ocraciun/carbon_monoxide_controller/docs/documentatie.pdf

# Circuit pentru controlul concentrației de monoxid de carbon într-o incintǎ

### Tehnici CAD

D I N C L U J - N A P O C A

UNIVERSITATEA
TEHNICA

### Crǎciun Octavian Ionuț

### 30 mai 2024

### Cuprins

1 Date de proiectare | 2
2 Fundamentare teoretică | 3
3 Proiectarea circuitului | 9
4 Breviar de calcul | 12
5 Rezultate si simulǎri | 15
Bibliografie | 22

### Capitolul 1

### Date de proiectare

Sǎ se proiecteze un sistem care utilizeazǎ senzori de gaz rezistivi pentru a menține într-o incintǎ concentrația de monoxid de carbon între limitele specificate in Tabela 1.1. În incintǎ existǎ o sursǎ care genereazǎ încontinuu monoxid de carbon. În momentul în care concentrația a ajuns la limita superioarǎ, sistemul va porni ventilatorul care va introduce aer curat. Când concentrația de monoxid de carbon ajunge la limita inferioarǎ sistemul va da comanda de oprire a ventilatorului.
Din foaia de catalog se știe cǎ la variația de gaz specificatǎ in Tabela 1.1 rezistența electricǎ a senzorului variazǎ liniar în domeniul specificat.
Variația rezistenței electrice a senzorului trebuie convertitǎ într-o variație de tensiune în domeniul [2V; (V CC − 2V)].
Ventilatorul este comandat de un comparator cu histerezǎ prin intermediul unui releu care este modelat cu un rezistor. Starea ventilatorului este semnalizatǎ de un LED de culoare verde.
concentrația de monoxid de carbon în incintǎ [ppm] | domeniul de mǎsurare a senzorului [ppm] | rezistența senzorului [Ω] | VCC [V]
200 – 4000 | 10 – 8000 | 55K – 45K | 11

Tabela 1.1: Date de proiectare

### Capitolul 2

### Fundamentare teoretică

Senzorii rezistivi sunt printre cei mai comuni tipuri de senzori, sunt ieftin de produs şi destul de uşor de conectat în circuit. Aceşti senzori produc o micǎ schimbare a rezistenței lor echivalente la modificǎri ale mediului exterior (în cazul nostru, a cantitǎții de monoxid de carbon), de aceea, pentru a mǎsura cât mai exact aceastǎ schimbare, este nevoie de o acuratețe cât mai bunǎ.
O tehnicǎ de mǎsurare a rezistenței senzorului (prezentatǎ in Figura 2.1) este de a forța un curent constant prin acesta, și sǎ se mǎsoare tensiunea care cade pe el. Dezavantajul acestei metode este cǎ necesitǎ o sursǎ de curent foarte exactǎ, deoarece orice modificare a valorii curentului generat de sursǎ v-a fi interpretatǎ la ieșire ca o modificare a rezistenței senzorului.

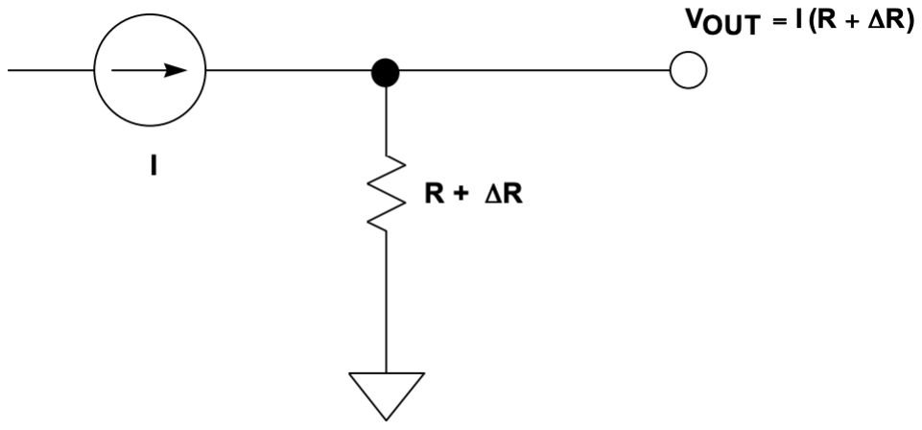
[picture p1: figure]

Figura 2.1: Mǎsurarea indirectǎ a rezistenței

### 2.1 Puntea Wheatstone în regim dezechilibrat

O alternativǎ pentru mǎsurarea schimbǎrilor mici ale rezistenței o prezintǎ circuitele in punte. Puntea Wheatstone în regim dezechilibrat prezentatǎ în Figura 2.2 este utilizatǎ la mǎsurarea pe cale electricǎ a unor mǎrimi neelectrice (in cazul nostru, pentru mǎsurarea cantitǎții de monoxid de carbon). Variațiile senzorului rezistiv ∆R sunt convertite într-o variație de tensiune ∆Vo.

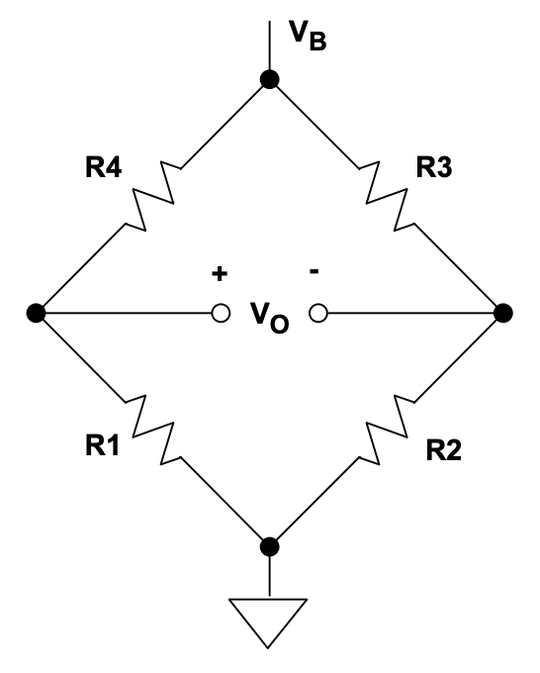
[picture p2: figure]

Figura 2.2: Puntea Wheatstone

### 2.1.1 Principiul de funcționare

În diagonala de alimentare a punții se conecteazǎ o sursǎ de tensiune continuǎ având rezistența echivalentǎ 0 Ω şi tensiunea Ua de 11 V. În diagonala de mǎsurare a punții se conecteazǎ un amplificator de instrumentație, având impedanța de intrare foarte mare in comparație cu rezistența de ieșire a punții, încât circuitul de mǎsurare funcționeazǎ în gol [2]. Astfel, este propriu sǎ caracterizǎm puntea prin sensibilitatea relativǎ în tensiune prezentatǎ prin Ecuația 2.1. Tensiunea în diagonala de mǎsurare a punții este prezentatǎ in Ecuația 2.2.

S =

∆Vo
VB
∆R
R

(2.1)

∆Vo = VB ·

R1
R1 + R2

− VB ·

R4
R3 + R4

(2.2)

Inițial, valorile acestor rezistențe sunt egale (R1 = R2 = R3 = R4 = R), întrucât puntea se aflǎ la echilibru deci ∆Vo = 0. Pentru o micǎ variație a rezistenței R4 = R + ∆R, celelalte valori ale rezistențelor rǎmân neschimbate, iar Ecuația 2.2 devine:

∆Vo = −

VB
4

∆R
R +

∆R
2

(2.3)

Ideal ar fi ca mǎrimea de ieșire ∆Vo sǎ varieze liniar in raport cu mǎrimea de intrare, ∆R, astfel se poate defini valoarea idealǎ și eroarea relativǎ de neliniaritate:

∆Videal =

VB
4

∆R
R

(2.4)

εrn =

∆V − ∆Videal

∆Videal

= −

∆R
2R

(2.5)

### 2.2 Amplificatorul de instrumentație

Pentru conversia variației tensiunii ∆Vo de la ieșirea punții wheatstone la domeniul cerut in datele de proiectare, se va utiliza un amplificator de instrumentație ca in Figura 2.3. Aceste tipuri de amplificator oferǎ o bunǎ stabilitate a amplificǎrii (setatǎ cu ajutorul unei singure rezistențe, RG), nu dezechilibreazǎ puntea şi oferǎ o bunǎ rejecție a semnalelor de mod comun (CMR).

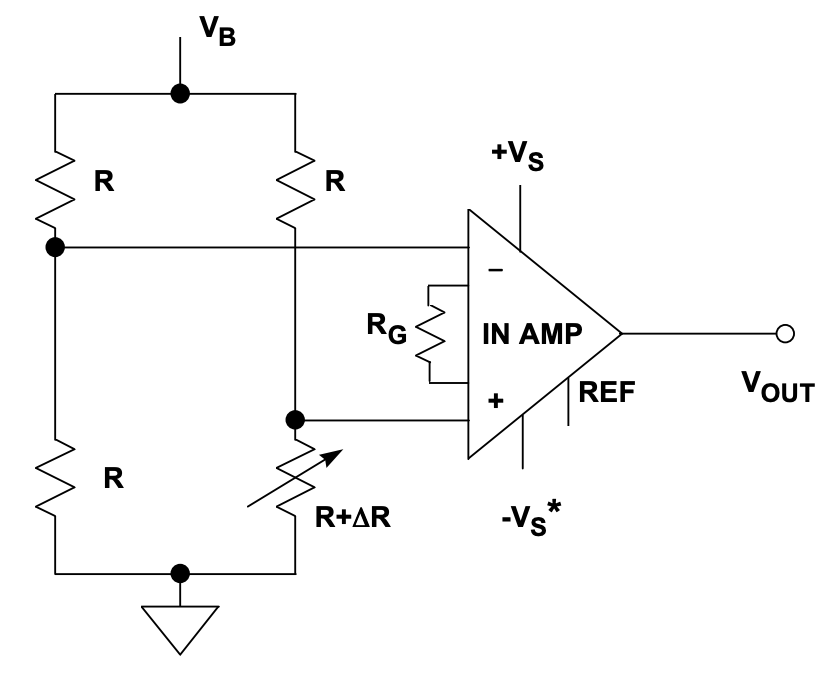
[picture p3: figure]

Figura 2.3: Utilizarea unui INA cu puntea wheatstone conform[5]

### 2.2.1 Principiul de funcționare

Variația tensiunii de pe ieșirea punții se va transforma într-o variație de tensiune la ieșirea INA confrom Ecuației 2.6. Se poate observa cǎ tensiunea de mod comun de pe cele douǎ intrari ale amplificatorului de instrumentație nu este prezentǎ la ieșirea acestuia, ci doar tensiunea diferențialǎ.

VOUT = (V

+ − V

−) ∗ Gain + VREF | (2.6)

### 2.2.2 Filtrarea zgomotului şi a interferenței electromagnetice

Undele radio de înaltǎ frecvențǎ (RFI) şi zgomotul surselor de tensiune afecteazǎ în mod negativ performanțele circuitelor analogice de precizie. Chiar dacǎ frecvențele acestor surse de zgomot nu intrǎ în lǎțimea de bandǎ a amplificatorului de instrumentație, acest zgomot poate ajunge în interiorul amplificatorului prin pinii de intrare, ieșire sau alimentare, unde este redresat și v-a produce un decalaj a semnalului de ieșire. Din aceste motive, este necesarǎ o bunǎ filtrare a intrǎrilor amplificatorului şi a alimentǎrii acestuia. În Figura 2.4 este prezentatǎ o schemǎ de principiu a unui filtru adecvat pentru intrǎrile amplificatorului de instrumentație. Aceastǎ schemǎ conține filtrul de mod comun (R1 : C1, R2 : C2) și filtrul diferențial (R1 + R2 : C3). Valorile R1, R2, C1, C2 se calculeazǎ conform Ecuației 2.7, și este important sǎ se asigure o bunǎ potrivire a acestor valori (R1 = R2, C1 = C2), de aceea este necesarǎ utilizarea componentelor cu o toleranțǎ cât mai micǎ. Valoarea condensatorului C3 se calculeazǎ conform Ecuației 2.8, și ajutǎ la atenuarea semnalului diferențial care rezultǎ din potrivirea inexactǎ a componentelor filtrului de mod comun. Lǎțimea de bandǎ a filtrului diferențial se calculeazǎ cu Ecuația 2.9, și trebuie sǎ fie de 100 de ori mai mare decât a semnalului de la intrare pentru a ne asigura cǎ acesta nu este atenuat. Un alt punct important in alegerea rezistențelor R1, R2 este cǎ valorile acestora trebuie sǎ fie destul de mari pentru a nu fi vǎzute ca o sarcinǎ de cǎtre puntea wheatstone.

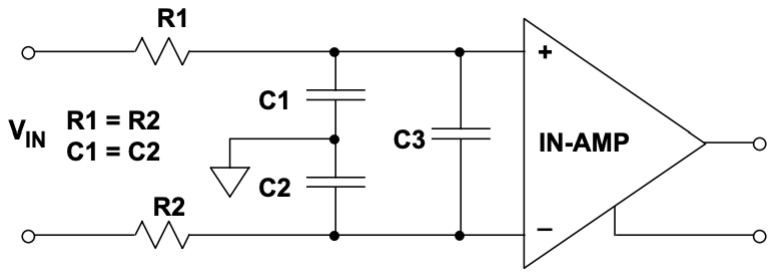
[picture p4: figure]

Figura 2.4: Filtrarea intrǎrilor amplificatorului de instrumentație conform [5]

τCM = R1C1 = R2C2 | (2.7)
τDIF F = (R1 + R2)C3 | (2.8)

BWDIF F =

1
2π(R1 + R2)[ C1C2
C1+C2

+ C3]

(2.9)

Pentru filtrarea zgomotului de la alimentarea amplificatorului de instrumentație se vor folosi condensatoare ca in Figura 2.5a, numite si condensatoare de bypass. Pentru a obține o bandǎ mai largǎ de frecvențe filtrate, este necesarǎ utilizarea mai multor condensatoare de valori diferite conectate in paralel, dupǎ cum se poate observa in Figura 2.5b.

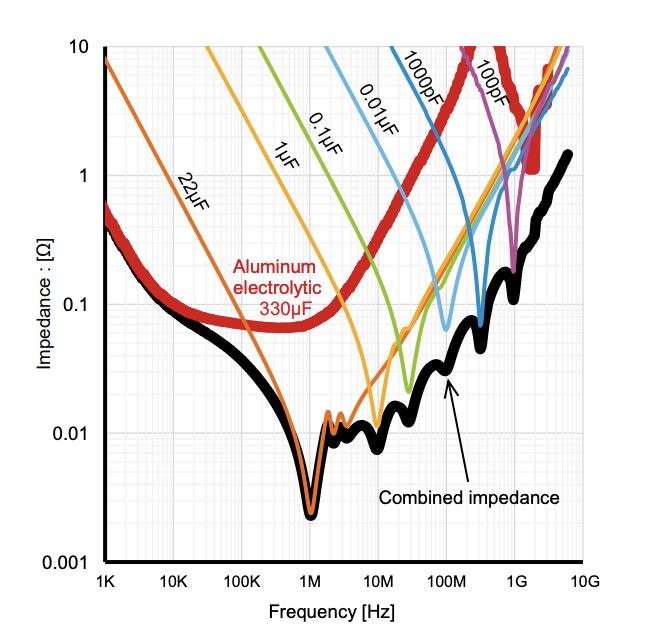
[picture p5: figure]
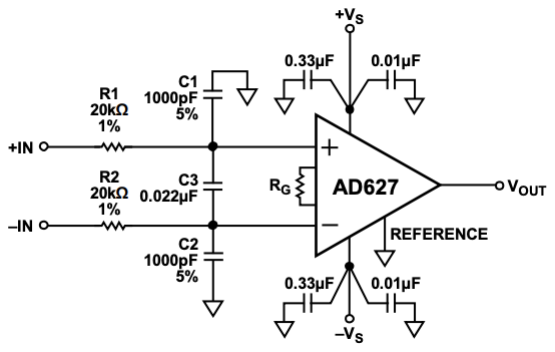
[picture p6: figure]

(a) Filtrarea alimentǎrii conform [3] | (b) Caracteristica impedanței mai multor condensatoare conectate in paralel conform [9]

Figura 2.5: Utilizarea condensatoarelor de bypass pentru filtrarea alimentarii

### 2.3 Detectorul de nivel

Pentru detectarea celor douǎ niveluri de tensiune necesare pornirii și opririi ventilatorului se va utiliza un comparator neinversor cu histerezǎ ca în Figura 2.6a.

### 2.3.1 Principiul de funcționare

Cele douǎ tensiuni de prag se obțin prin aducerea la intrarea neinversoare a amplificatorului a unei pǎrți din tensiunea de ieşire (reacție pozitivǎ). Pentru translatarea pragurilor spre o anumitǎ valoare se va aplica o tensiune continuǎ (VRef ) la intrarea inversoare a amplificatorului [6].

V

+ =

R1
R1 + R2

Vo +

R2
R1 + R2
Vi | (2.10)

V

− = VRef | (2.11)

Pentru cǎ amplificatorul are reacție, tensiunile de pe intrarea inversoare și cea neinversoare sunt egale. Egalând ecuația 2.10 cu ecuația 2.11 și înlocuind Vi cu Vp rezultǎ ecuația 2.12 pentru tensiunea de prag.

Vp = (1 + R1
R2

)VRef −

R1
R2
Vo | (2.12)

Înlocuind in Ecuația 2.12 tensiunea de ieşire (Vo) cu valoarea maximǎ a ieşirii (VOH) se determinǎ pragul inferior (VP L), respectiv cu valoarea minimǎ a ieşirii (VOL) se determinǎ pragul superior (VP L).

VP L = (1 + R1
R2

)VRef −

R1
R2
VOH | (2.13)

VP H = (1 + R1
R2

)VRef −

R1
R2
VOL | (2.14)

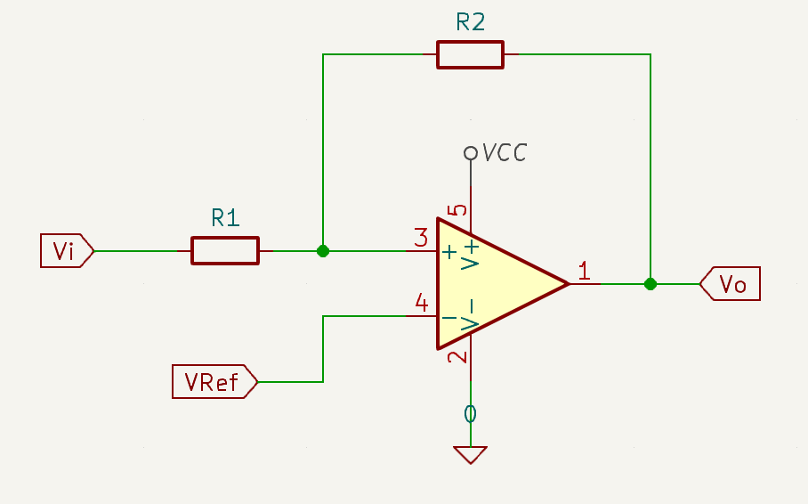
[picture p7: figure]

(a) Schemǎ

Vi

Vo

VP L VP H

VOL

VOH

(b) CSTV

Figura 2.6: Comparatorul neinversor cu histerezǎ

Pentru determinarea tensiunii de referințǎ (VRef ), analizǎm circuitul când valoarea tensiunii de intrare (Vi) este la pragul superior (VP H). Chiar în acest moment, valoarea tensiunii de ieșire este VOL, și tranziția cǎtre VOH este inițiatǎ. Astfel, din ecuațiile 2.10 și 2.11 rezultǎ ecuația 2.15

VRef =

R1
R1 + R2

VOL +

R2
R1 + R2
VP H | (2.15)

### 2.4 Circuitul de comandǎ al ventilatorului

Deoarece pentru comanda releului este necesar un curent destul de semnificativ (de ordinul zecilor sau chiar sutelor de miliamperi), iar majoritatea amplificatoarelor operaționale nu pot susține așa curenți, este necesarǎ utilizarea unui circuit de comandǎ. Cel mai simplu circuit de acest gen este un tranzistor care functioneazǎ ca un întrerupǎtor precum cel prezentat în Figura 2.7.

### 2.4.1 Principiul de funcționare

Când tensiunea de intrare este mai micǎ decât tensiunea de prag a tranzistorului, acesta este în regiunea de blocare, și funcționeazǎ ca un întrerupator deschis, deci prin bobina releului nu circulǎ curent.

VGS < VT H | (2.16)
RDSoff = ∞ | (2.17)
VDS = V CC | (2.18)
ID = 0 | (2.19)

În regiunea de triodǎ (regiunea linearǎ), tranzistorul se comportǎ ca un întrerupǎtor închis, având rezistența RDSon

foarte micǎ, motiv pentru care curentul prin acesta ID este maxim.

VGS > VT H | (2.20)
RDSon < 0.1Ω | (2.21)
VDS = 0.2V | (2.22)

ID =

V CC − VDS Rload | (2.23)

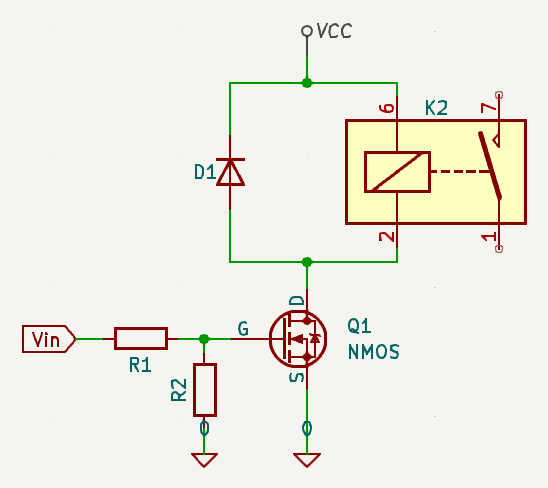
[picture p8: figure]

Figura 2.7: Comanda unui releu

Pentru cǎ bobina releului are un caracter inductiv, în momentul când curentul prin aceasta începe sǎ scadǎ, o tensiune instantanee este generatǎ pentru a se împotrivi schimbǎrii curentului. Din cauzǎ cǎ aceasta tensiune instantanee poate sǎ ajungǎ la valori mult mai mari decât tensiunea maximǎ suportatǎ de tranzistor (VDSmax ), este necesar sǎ se asigure protecția tranzistorului. O metodǎ simplǎ de protecție este conectarea unei diode in paralel cu terminalele releului (D1 din Figura 2.7).

### Capitolul 3

### Proiectarea circuitului

### 3.1 Schema bloc

Schema bloc a circuitului este prezentatǎ în Figura 3.1, și conține blocul de mǎsurare, blocul convertorului de domeniu, blocul de comparare, blocul de comandǎ, și blocul de generare a tensiunilor continue necesare alimantǎrii celorlalte blocuri.

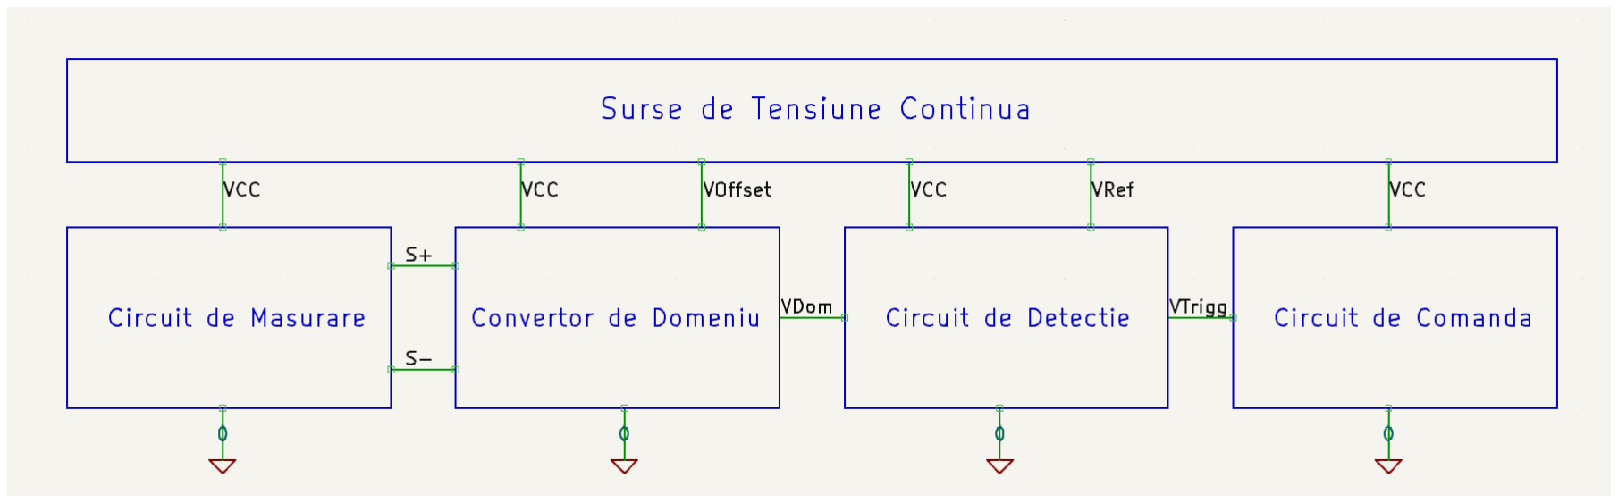
[picture p9: figure]

Figura 3.1: Schema Bloc

### 3.2 Blocul de mǎsurare

Blocul de mǎsurare prezentat în Figura 3.2 este format din puntea wheatstone, și se ocupǎ cu mǎsurarea concentrației de monoxid de carbon din incintǎ, și conversia acesteia într-o variație de tensiune. Pentru alimentare acest bloc este conectat la VCC și GND, iar ca ieşire are semnalul diferențial reprezentând variația senzorului (S+ şi S-), prezentatǎ în Tabela 4.1.
Pentru valorile rezistențelor s-a folosit standardul E192, cu toleranța de 0.1% conform [1].

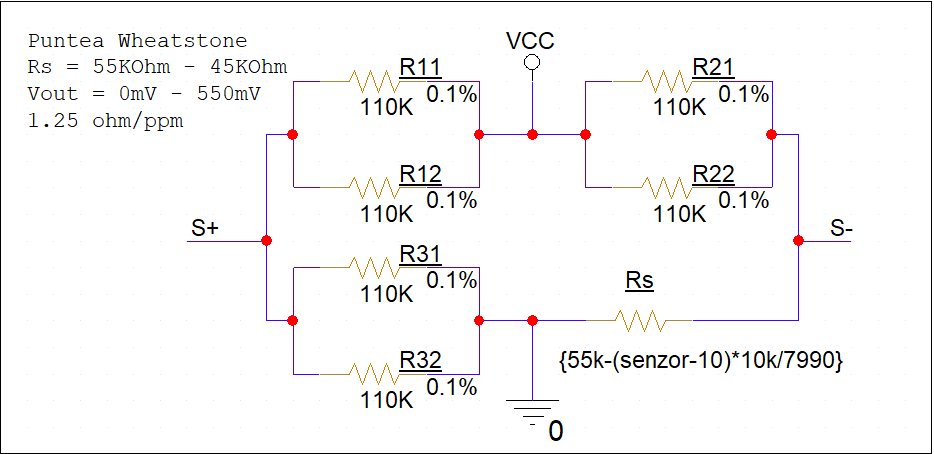
[picture p10: figure]

Figura 3.2: Implementarea blocului de mǎsurare

### 3.3 Blocul convertorului de domeniu

Blocul convertorului de domeniu (Figura 3.3) conține amplificatorul de instrumentație, și se ocupǎ de convertirea tensiunii de la ieșirea blocului de mǎsurare în domeniul specificat în datele de proiectare (Tabela 1.1). Intrǎrile acestuia sunt conectate la ieșirile blocului de mǎsurare (S+ şi S−), iar ca ieșire are semnalul VDom. Ca surse de tensiune continuǎ este conectat la VCC, GND și VOffset.

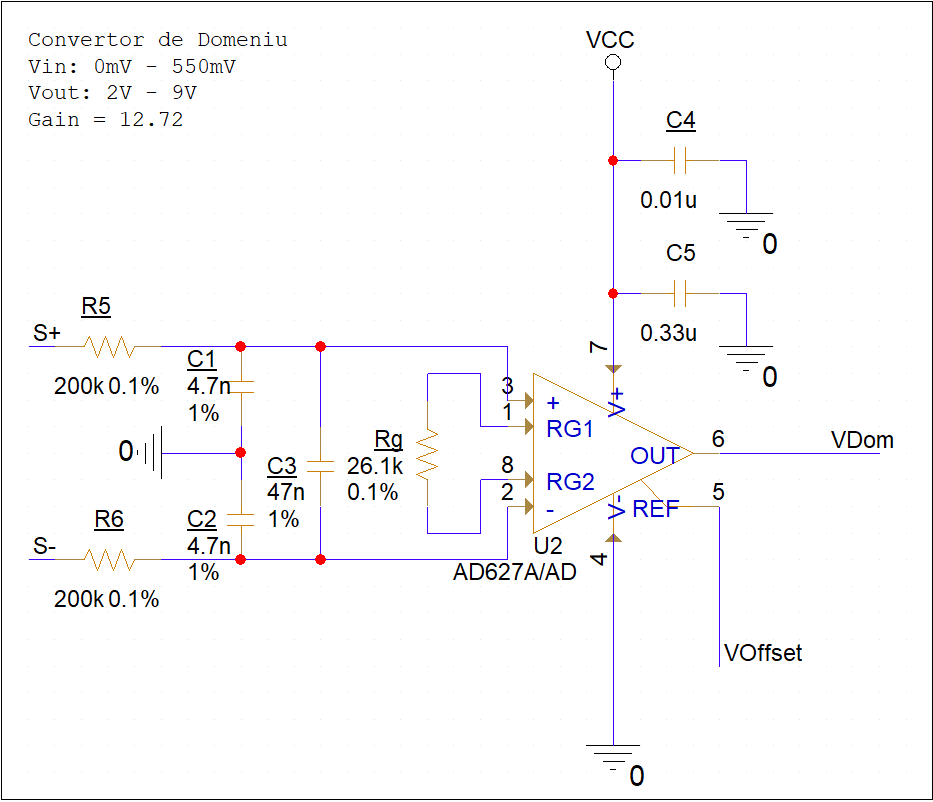
[picture p11: figure]

Figura 3.3: Implementarea blocului convertorului de domeniu

### 3.4 Blocul de comparare

Blocul de comparare (Figura 3.4a) conține comparatorul neinversor cu histerezǎ, și se ocupǎ cu detectarea pragurilor de tensiune echivalente concentrației de monoxid de carbon din Tabela 1.1. Acest bloc este conectat la ieșirea blocului convertorului de domeniu, iar pentru surse de tensiune continuǎ la VCC, GND și VRef. Ieșirea acestui bloc VT rigg este un semnal logic, având valorile GND sau VCC. Când valoarea tensiunii de intrare VDom atinge valoarea pragului superior, ieșirea acestui bloc, VT rigg, comutǎ la VCC, iar cand VDom atinge valoarea pragului inferior, aceasta comutǎ la GND.

### 3.5 Blocul de comandǎ

Blocul de comandǎ (Figura 3.4b) se ocupǎ de controlul ventilatorului, acesta având ca intrare semnalul VT rigg de la ieșirea blocului de comparare. Pentru acționarea releului, este nevoie de un curent semnificativ (60 mA conform foii de catalog a releului [8]) pe care ieșirea amplificatorului AD820 nu îl poate furniza (conform foii de catalog a AD820 [4] este maxim 20 mA). Din acest motiv, controlul releului se realizeazǎ cu un tranzistor NMOS, cu rezistența RDS foarte micǎ (conform foii de catalog a IRLML2502 [7] de doar 0.045 Ω).
Rezistența R40 are rolul de a limita curentul datorat de încǎrcarea/descǎrcarea capacitǎții din grila tranzistorului. Valoarea acesteia se alege în funcție de valoarea sarcinii electrice (Qg din foaia de catalog a tranzistorului [7]), a timpului de comutare (o valoare mare are ca efect un timp de

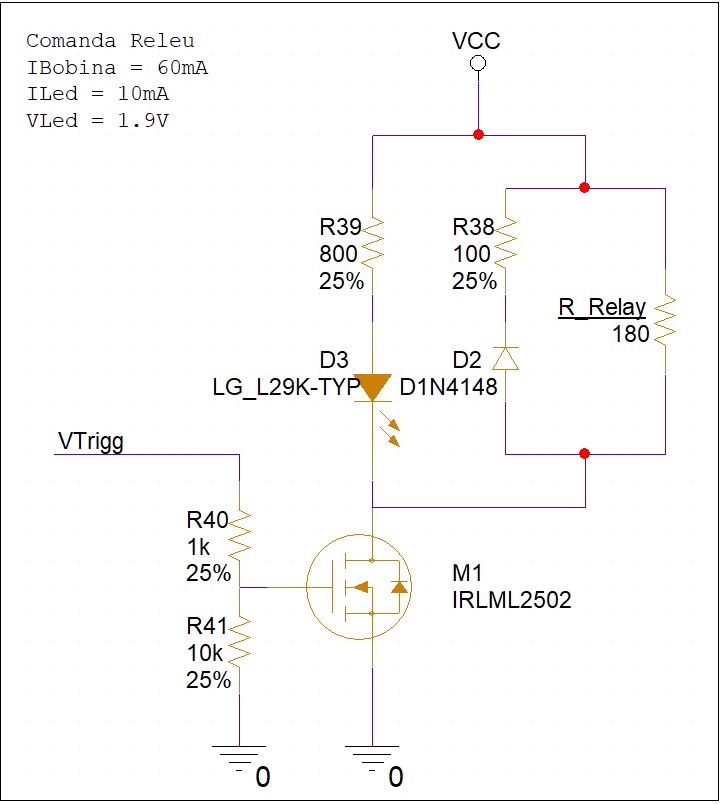
[picture p12: figure]
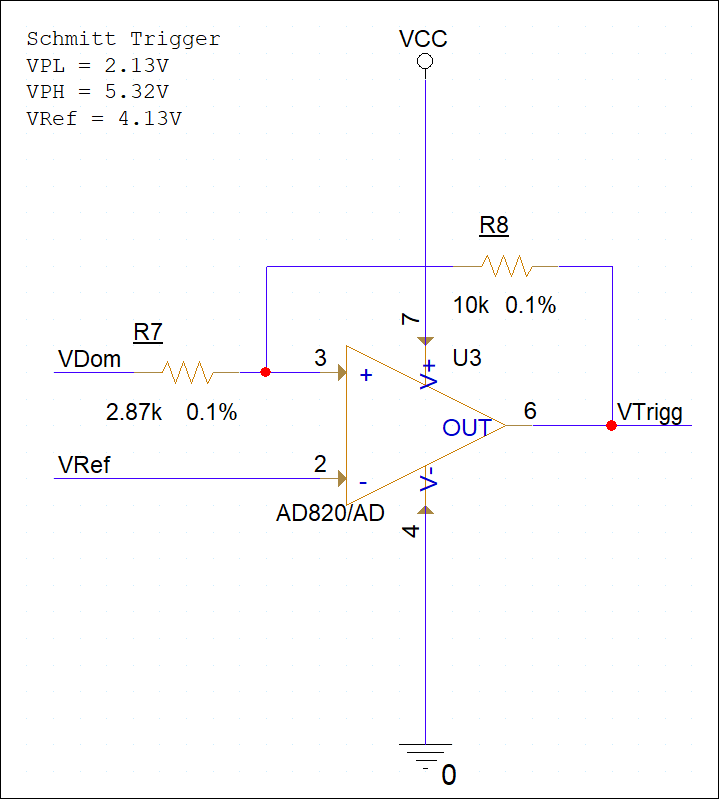
[picture p13: figure]

(a) Implementarea detectorului de nivele | (b) Implementarea blocului de comandǎ

Figura 3.4: Schema blocului de comparare si comandǎ

comutare mare), și de intensitatea curentului care este permis la ieșirea comparatorului.

### 3.6 Blocul surselor de tensiune

Blocul surselor de tensiune se ocupǎ cu generarea tensiunilor continue necesare alimentǎrii celorlalte blocuri, VCC, VOf fset și VRef .

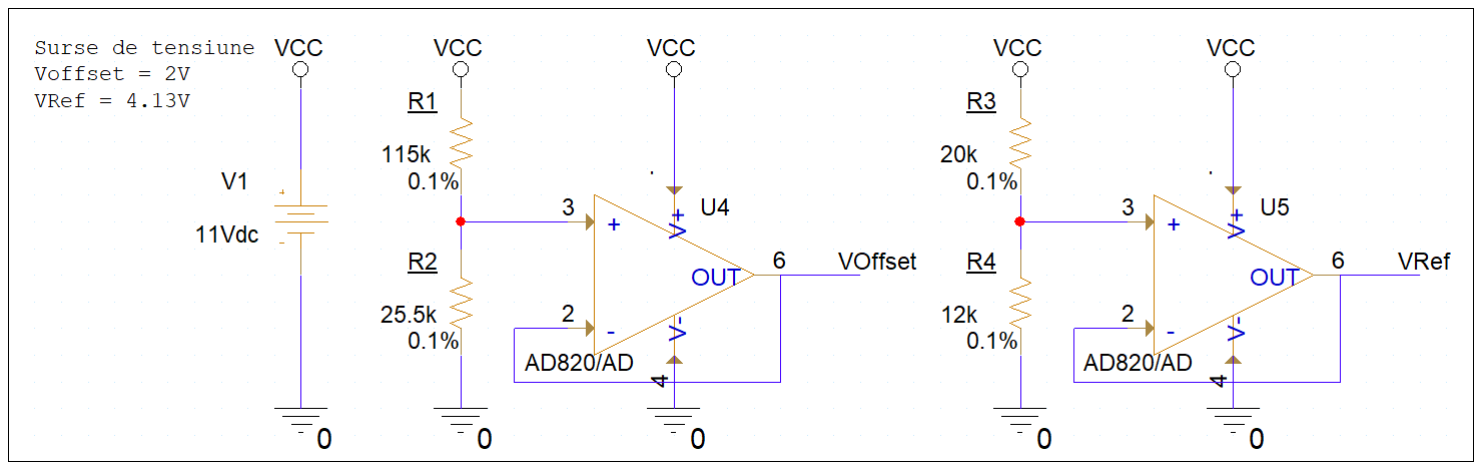
[picture p14: figure]

Figura 3.5: Implementarea surselor de tensiune

### Capitolul 4

### Breviar de calcul

### 4.1 Blocul de mǎsurare

Pentru calculul variație de tensiune de la ieșirea blocului de mǎsurare se utilizeazǎ formula 2.3, în care VB are valoarea VCC (11 V), iar pentru R s-a ales valoarea de 55 KΩ astfel încât puntea este echilibratǎ la capǎtul inferior al domeniului de mǎsurare al senzorului Rs.

∆R = 0 Ω => ∆Vo = 0 V | (4.1)
∆R = 10 KΩ => ∆Vo = 550 mV | (4.2)
S = 0.275 | (4.3)
∆Videal = 500 mV | (4.4)
εrn = 10 % | (4.5)

Pentru transformarea valorii concentrației de monoxid de carbon din incintǎ în valoarea rezistenței senzorului se foloseste interpolarea liniarǎ a celor douǎ domenii (Ecuația 4.6) rezultând valorile pragurilor din tabelul 4.1

RS(x) = RSmin + (x − COmin) ·

RSmax − RSmin COmax − COmin | (4.6)
CO [ppm] | RS[Ω] | ∆R [Ω] | S+ − S−[mV]
200 4000 | 54762.2 50006.2 | 237.8 4993.7 | 12 261.5

Tabela 4.1: Nivelurile de tensiune la ieșirea blocului de mǎsurare

### 4.2 Blocul convertorului de domeniu

Pentru convertirea domeniului tensiunii diferențiale S+ − S− din tabelul 4.1, în domeniul din partea de cerințǎ, este necesarǎ calcularea amplificǎrii, a rezistenței de gain, şi a tensiunii continue

VOf fset.
Pentru cǎ la intrarea amplificatorului de instrumentație avem o variație de [0 mV; 550 mV] iar la ieșirea acestuia avem nevoie de o variație de [2V; 9V], se deduc conform ecuației 2.6 urmǎtoarele valori: VOf fset = 2 V și Gain = 12.72.
Conform foii de catalog al amplificatorului AD627 [3], ecuația de calcul al rezistenței de gain este:
Rg =

200 KΩ
Gain − 5

(4.7)

de unde rezultǎ cǎ pentru a avea o amplificare de 12.72, este nevoie de o rezistențǎ Rg = 26.1 KΩ. Astfel, nivelele de tensiune din tabelul 4.1 vor deveni:

S+ − S−[mV] | VDom [V]
12 261.5 | 2.13 5.31

Tabela 4.2: Nivelurile de tensiune la ieșirea blocului de conversie a domeniului

### 4.3 Blocul de comparare

Pentru detectarea pragurilor din Tabela 4.2, avem VP L = 2.13 V și VP H = 5.31 V. Analizând circuitul când ieșirea este 0V, și tensiunea VDom ajunge la pragul VP H = 5.31V , Ecuația 2.15 devine:
VRef = 5.31 ∗

R2
R1 + R2

(4.8)

Similar, analizând circuitul când ieșirea este la 11V și tensiunea VDom ajunge la pragul VP L = 2.13V , utilizând Ecuațiile 2.10 și 2.11 rezultǎ:

VRef = 2.13 ∗

R2
R1 + R2

+ 11 ∗

R1
R1 + R2

(4.9)

Egalând 4.8 cu 4.9 și alegând R2 = 10 KΩ avem:

5.31 V ∗ 10 KΩ
R1 + 10 KΩ

=

2.13 V ∗ 10 KΩ + 11 V ∗ R1 R1 + 10 KΩ

(4.10)

de unde rezultǎ R1 = 2.89 KΩ. Utilizând Ecuația 4.8, obținem VRef = 4.13 V.

### 4.4 Blocul de comandǎ

Când VT rigg = 0 V, tensiunea VGS = 0 V și tranzistorul este blocat, deci prin releu nu circulǎ curent, la fel și prin led, acesta fiind stins. Când VT rigg = 11 V, tensiunea VGS =

R41
R40+R41

∗V CC =
10 V, deci tranzistorul este in regiunea liniarǎ (se comportǎ ca o rezistențǎ, având RDS foarte micǎ).
ILED = 10 mA | (4.11)
VLED = 1.9 V | (4.12)

RLED =

V CC − VLED

ILED

= 910 Ω | (4.13)

IReleu =

V CC

RReleu

= 60 mA | (4.14)

PReleu = I

2
Releu · RReleu = 670 mW | (4.15)
ID = ILED + IReleu = 70 mA | (4.16)
VDS = 2 mV | (4.17)

RDS =

VDS
ID
= 0.028 Ω | (4.18)

PNMOS = I

2
D ∗ RDS = 137.2 mW | (4.19)

### 4.5 Surse de tensiune

Pentru generarea surselor de tensiune continuǎ VOf fset = 2 V și VRef = 4.13 V se folosesc divizoare de tensiune și buffere.

VOf fset =

R2
R1 + R2
- V CC = 2 V | (4.20)
R1 = 115 KΩ | (4.21)
R2 = 25.5 KΩ | (4.22)

VRef =

R4
R3 + R4
- V CC = 4.13 V | (4.23)
R3 = 20 KΩ | (4.24)
R4 = 12 KΩ | (4.25)

### Capitolul 5

### Rezultate si simulǎri

### 5.1 Simularea tensiunii de ieșire de pe Puntea Wheatstone

Pentru simularea tensiunii de ieșire a punții Wheatstone, se creazǎ un profil de simulare de tip DC Sweep, in care se baleazǎ parametrul global ‘senzor‘ între valorile domeniului de mǎsurare (10 ppm – 8000 ppm), cu un pas de 1 ppm. Rezultate sunt prezentate in Figura 5.1, unde pe axa X este valoarea concentrației de monoxid de carbon din incintǎ în ppm, iar pe axa Y este valoarea tensiunii diferențiale S+ − S− in mV. Se poate observa cǎ la variația concentrației de monoxid de Date/Time run: 05/29/24 21:50:25

** Profile: "SCHEMATIC1-bias" [ c:\users\ionut\onedrive - technical university of cluj-napoca\facultate...

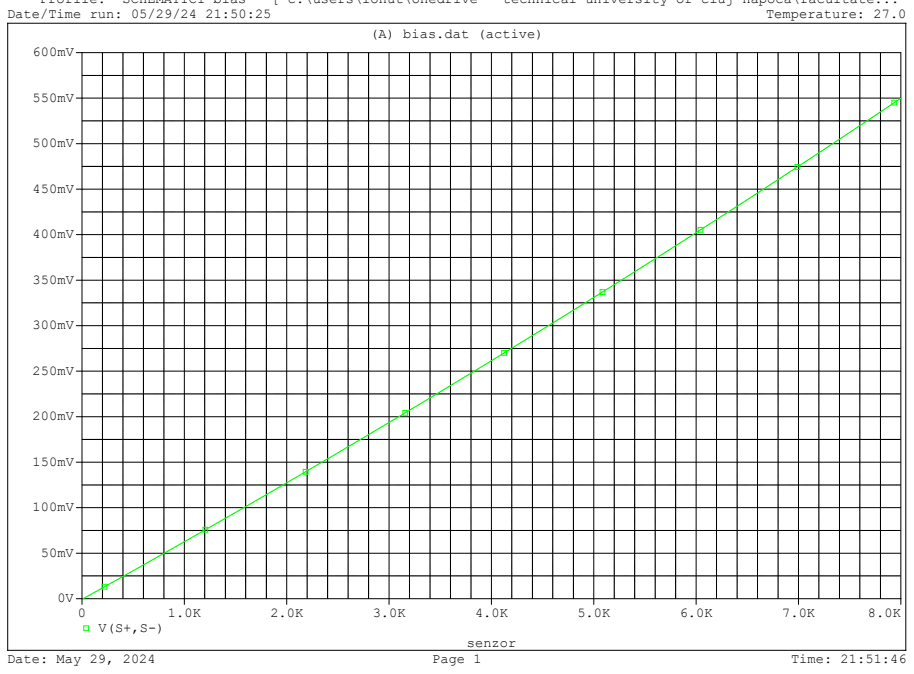
[picture p15: figure]
Temperature: 27.0; Date: May 29, 2024; Page 1; Time: 21:51:46; (A) bias.dat (active); senzor

Figura 5.1: Simularea tensiunii S+ − S−

carbon din incintǎ între valorile 10 ppm – 8000 ppm, tesiunea diferențialǎ S+ − S− variazǎ între 0 mV – 550 mV.

### 5.2 Simularea tensiunii de ieșire a convertorului de domeniu

Pentru simularea tensiunii de la ieșira convertorului de domeniu se foloseste același profil de simulare ca mai sus. Rezultate sunt prezentate in Figura 5.2, unde pe axa X este valoarea concentrației de monoxid de carbon din incintǎ în ppm, iar pe axa Y este valoarea tensiunii VDom in V. Se poate observa cǎ la variația concentrației de monoxid de carbon din incintǎ între valorile 10 ppm –

** Profile: "SCHEMATIC1-bias" [ c:\users\ionut\onedrive - technical university of cluj-napoca\facultate...

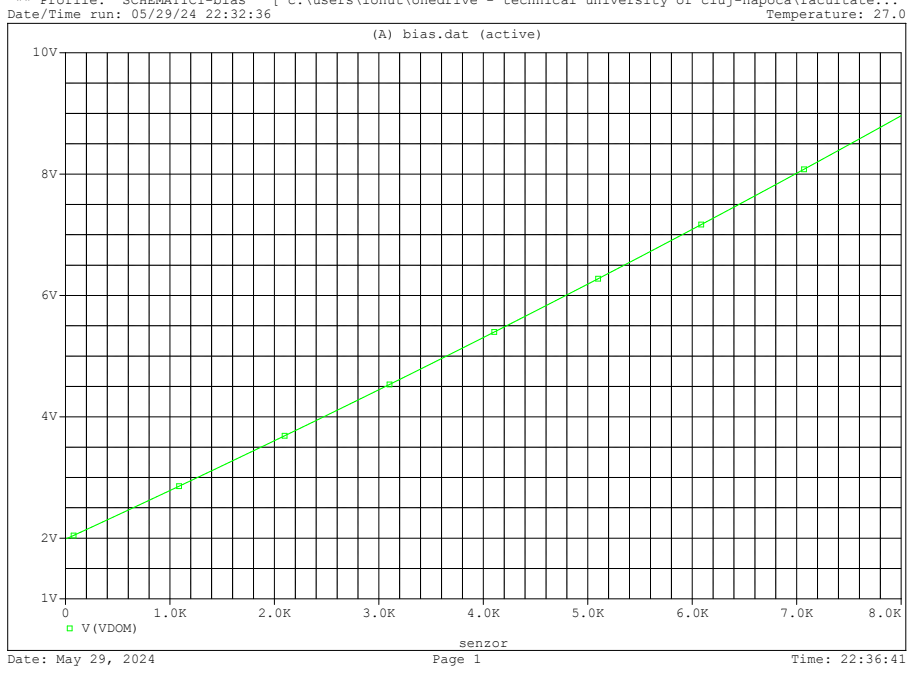
[picture p16: figure]
Date/Time run: 05/29/24 22:32:36; Temperature: 27.0; Date: May 29, 2024; Page 1; Time: 22:36:41; (A) bias.dat (active); senzor; V(VDOM)

Figura 5.2: Simularea tensiunii VDom

8000 ppm, tesiunea de ieșire a convertorului de domeniu VDom variazǎ între 2 V – 9 V.

### 5.3 Simularea pragurilor de comutare

Pentru simularea pragurilor de comutare a comparatorului neiversor cu histerezǎ, trebuie efectuate douǎ simulari diferite de timp DC Sweep în care se baleazǎ valoarea concentrației de monoxid de carbon ascendent (roșu) și descendent (verde). Pentru vizualizarea pragurilor pe același grafic ca in Figura 5.3, se concateneazǎ datele de simulare, și se afișeazǎ pe axa X valoarea concentrației de monoxid de carbon din incintǎ în ppm, iar pe axa Y valoarea tensiunii VT rigg de la ieșirea convertorului. Se observǎ ca la variația ascendentǎ a concentrației de monoxid de carbon, semnalul VT rigg comutǎ la 11 V când concentrația atinge valoarea de 4000 ppm. Similar, la variația descendentǎ, semnalul VT rigg comutǎ la 0 V când concentrația atinge valoare de 250 ppm, aici fiind o micǎ eroare fațǎ de 200 ppm din cauza componentelor alese (aproximǎri în calcule sau valori standard inexistente).

### 5.4 Analiza statisticǎ monte-carlo și worst-case

Pentru a vedea cum toleranțele componentelor afecteaza pragurile de comutare a comparatorului, se vor efectua douǎ analize statistice de tip monte carlo. În Figura 5.4 se observǎ cǎ valoarea pragului descendent la care comutǎ tensiunea VT rigg se modificǎ în funcție de valorile componentelor, între 126.504 ppm și 338.505 ppm, valoarea medie fiind 249.205 ppm. Similar, din Figura 5.5, rezultǎ cǎ valoarea pragului ascendent se modificǎ între 3876.5 ppm și 4084.5 ppm, media fiind la 3992.64 ppm.
Pentru a determina care componente afecteazǎ cel mai mult valoarea pragurilor, dar și efectul pe care toleranțele acestor componente îl au in modificarea pragurilor se efectueazǎ o analizǎ de

** Profile: "SCHEMATIC1-bias" [ c:\users\ionut\onedrive - technical university of cluj-napoca\facultate...

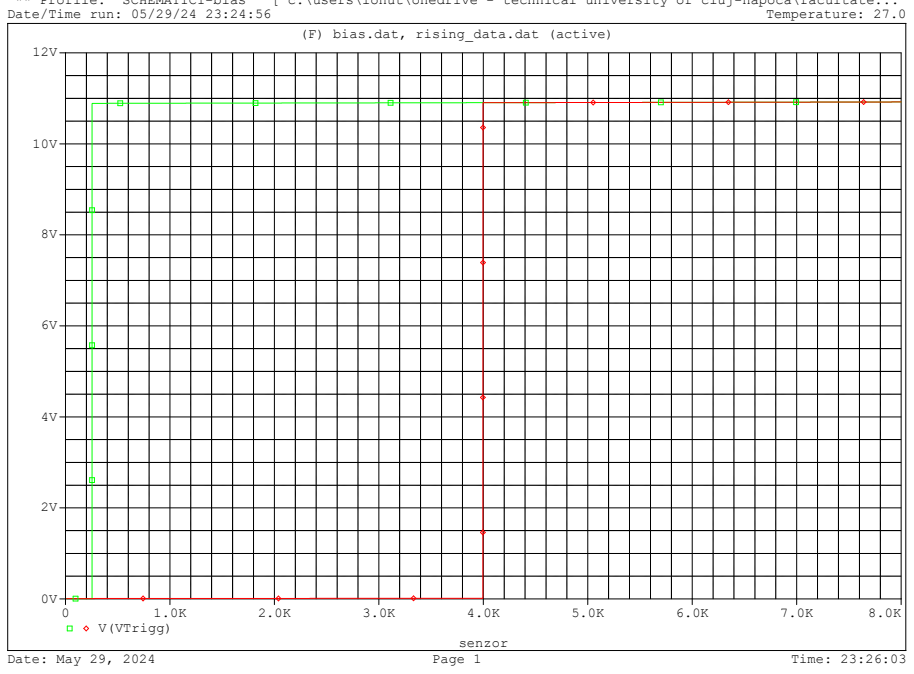
[picture p17: figure]
Date/Time run: 05/29/24 23:24:56; Temperature: 27.0; Date: May 29, 2024; Page 1; Time: 23:26:03; (F) bias.dat, rising_data.dat (active); senzor; V(VTrigg)

Figura 5.3: Simularea pragurilor de comutare a tensiunii VT rigg

** Profile: "SCHEMATIC1-monte_carlo_falling" [ c:\users\ionut\onedrive - technical university of cluj-n...

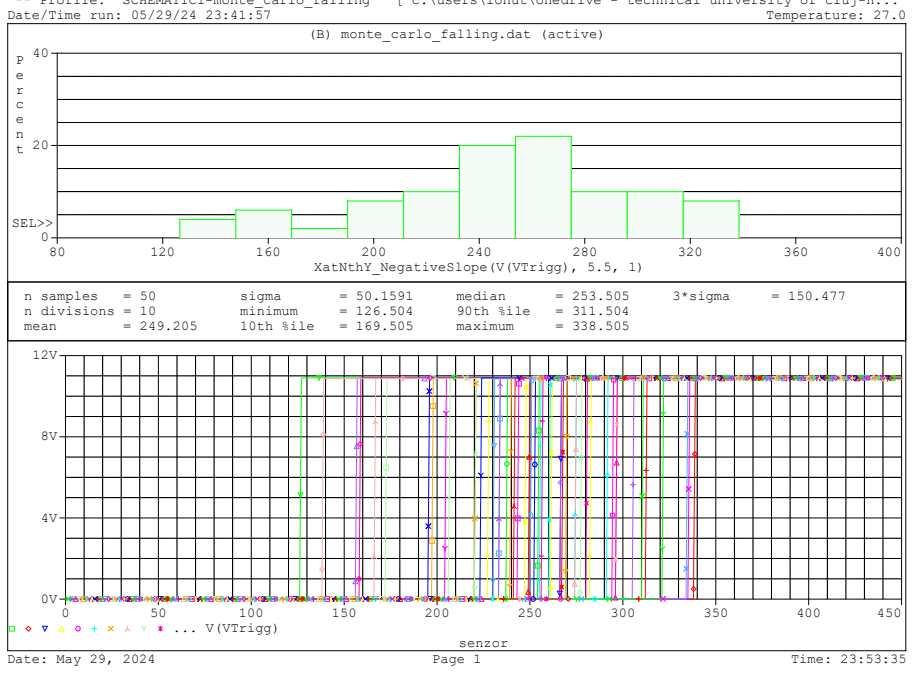
[picture p18: figure]
Date/Time run: 05/29/24 23:41:57; Temperature: 27.0; Date: May 29, 2024; Page 1; Time: 23:53:35; (B) monte_carlo_falling.dat (active); senzor; ... V(VTrigg); XatNthY_NegativeSlope(V(VTrigg), 5.5, 1); SEL>>; n samples; n divisions = 10; mean; sigma; minimum; 10th %ile; median; 90th %ile; maximum; 3*sigma

Figura 5.4: Analiza monte carlo pentru pragul descendent

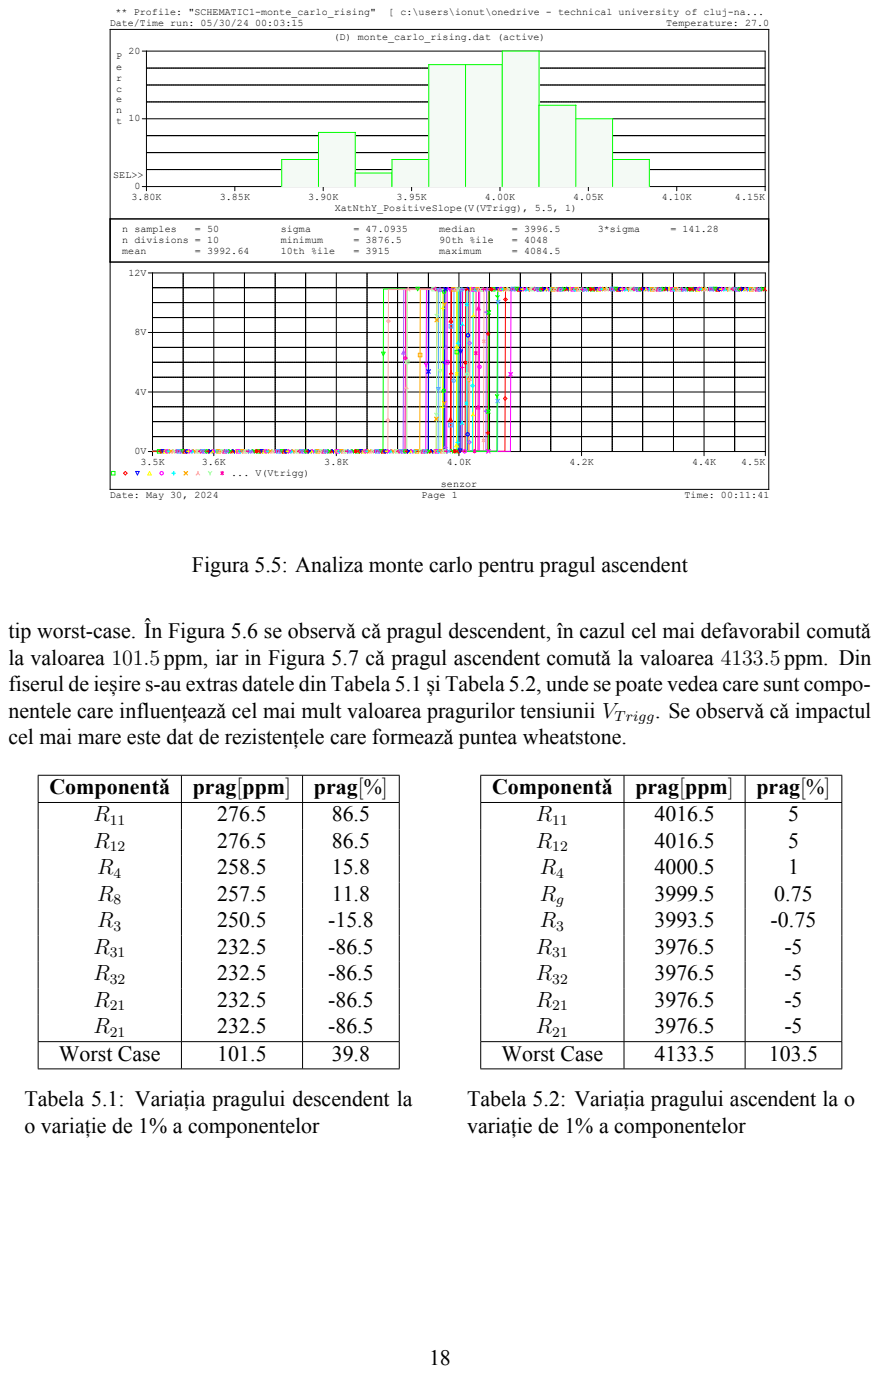
[picture p19: page 19]

** Profile: "SCHEMATIC1-monte_carlo_rising" [ c:\users\ionut\onedrive - technical university of cluj-na...
Date/Time run: 05/30/24 00:03:15

Figura 5.5: Analiza monte carlo pentru pragul ascendent

tip worst-case. În Figura 5.6 se observǎ cǎ pragul descendent, în cazul cel mai defavorabil comutǎ
la valoarea 101.5 ppm, iar in Figura 5.7 cǎ pragul ascendent comutǎ la valoarea 4133.5 ppm. Din
fiserul de ieșire s-au extras datele din Tabela 5.1 și Tabela 5.2, unde se poate vedea care sunt compo-
nentele care influențeazǎ cel mai mult valoarea pragurilor tensiunii VT rigg. Se observǎ cǎ impactul
cel mai mare este dat de rezistențele care formeazǎ puntea wheatstone.

Tabela 5.1: Variația pragului descendent la
o variație de 1% a componentelor

Tabela 5.2: Variația pragului ascendent la o
variație de 1% a componentelor

** Profile: "SCHEMATIC1-monte_carlo_falling" [ c:\users\ionut\onedrive - technical university of cluj-n...

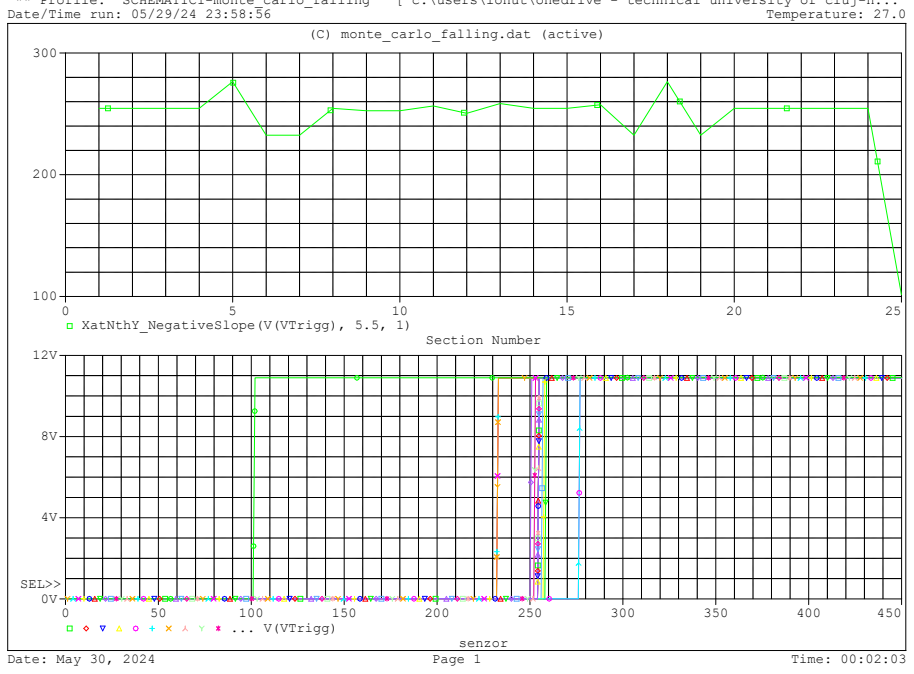
[picture p20: figure]
Date/Time run: 05/29/24 23:58:56; Temperature: 27.0; Date: May 30, 2024; Page 1; Time: 00:02:03; (C) monte_carlo_falling.dat (active); senzor; ... V(VTrigg); SEL>>; Section Number; XatNthY_NegativeSlope(V(VTrigg), 5.5, 1)

Figura 5.6: Analiza worst-case pentru pragul descendent

** Profile: "SCHEMATIC1-monte_carlo_rising" [ c:\users\ionut\onedrive - technical university of cluj-na...

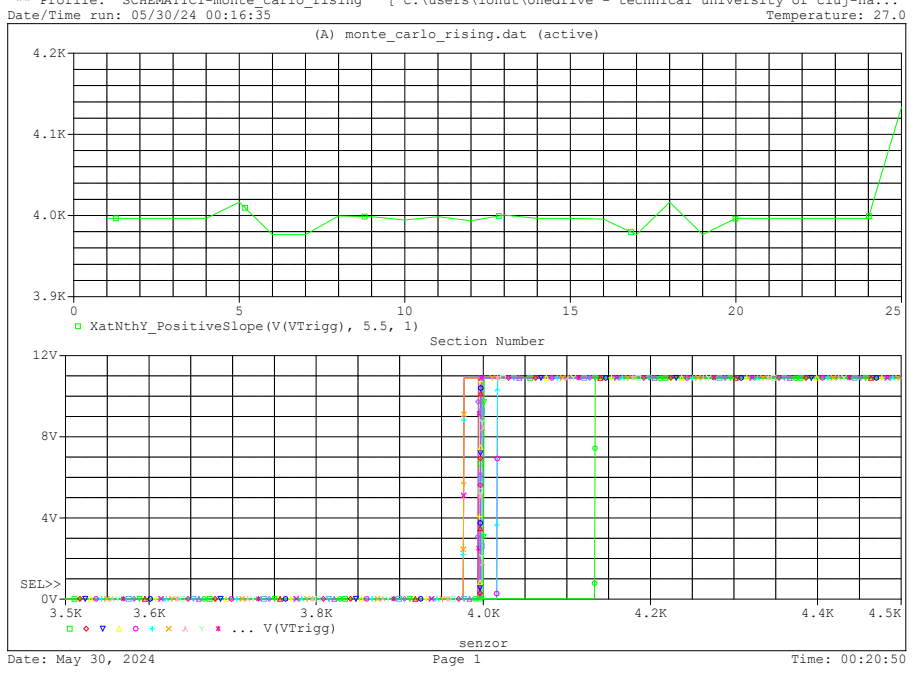
[picture p21: figure]
Date/Time run: 05/30/24 00:16:35; Temperature: 27.0; Date: May 30, 2024; Page 1; Time: 00:20:50; (A) monte_carlo_rising.dat (active); senzor; ... V(VTrigg); SEL>>; Section Number; XatNthY_PositiveSlope(V(VTrigg), 5.5, 1)

Figura 5.7: Analiza worst-case pentru pragul ascendent

### 5.5 Analiza de zgomot pentru amplificatorul de instrumentație

Pentru a arǎta rația de rejectare a semnalului de mod comun în funcție de frecvențǎ, trebuie efectuate 2 analize de tip AC Sweep. Pentru prima analizǎ, semnalul AC se aplicǎ ambelor intrǎri ale amplificatorul de instrumentație, astfel generând la ieșire valoarea tensiunii amplificate a semnalului de mod comun de la intrare. Pentru a doua analizǎ AC Sweep, semnalul AC se aplicǎ ca semnal diferențial la intrǎrile amplificatorului de instrumentație, astfel având la ieșire valoarea tensiunii amplificate a semnalului diferențial de la intrare. Pentru generarea graficului din figura 5.8 se împart datele din a doua rulare (amplificarea diferențialǎ), la datele din prima rulare (amplificarea de mod comun), și se afișeazǎ rezultatul în dB. Dupǎ cum se poate observa, INA cu amplificarea de 12.72 are un CMRR de peste 80 dB pânǎ la 100 Hz.

** Profile: "SCHEMATIC1-noise_CM" [ C:\Users\ionut\OneDrive - Technical University of Cluj-Napoca\facul...

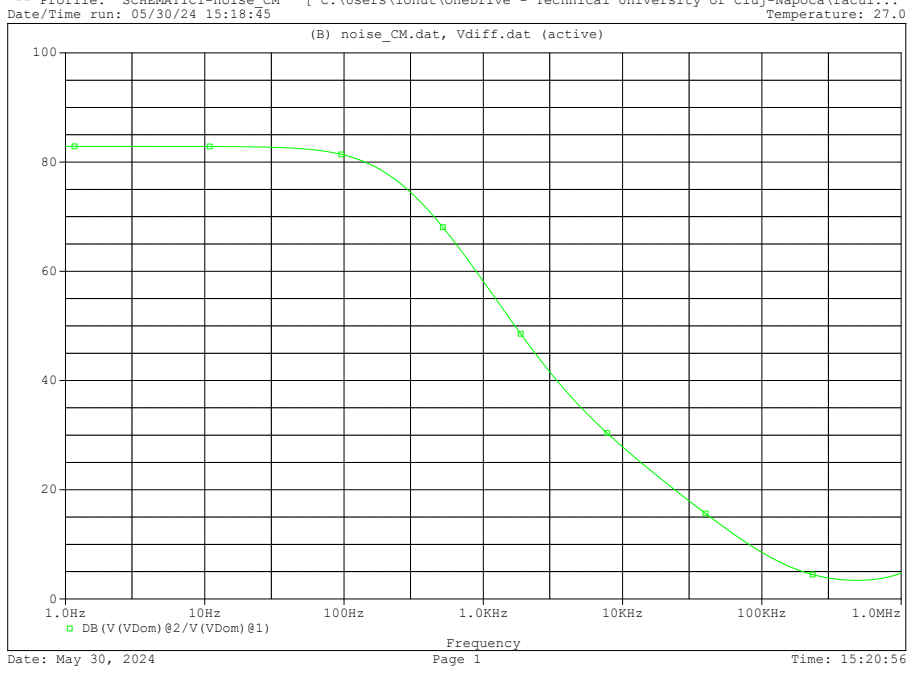
[picture p22: figure]
Date/Time run: 05/30/24 15:18:45; Temperature: 27.0; Date: May 30, 2024; Page 1; Time: 15:20:56; (B) noise_CM.dat, Vdiff.dat (active); Frequency; 1.0KHz; 10KHz; 100KHz; 1.0MHz; DB(V(VDom)@2/V(VDom)@1)

Figura 5.8: CMRR vs. frecvențǎ, 11V, Gain=12.72

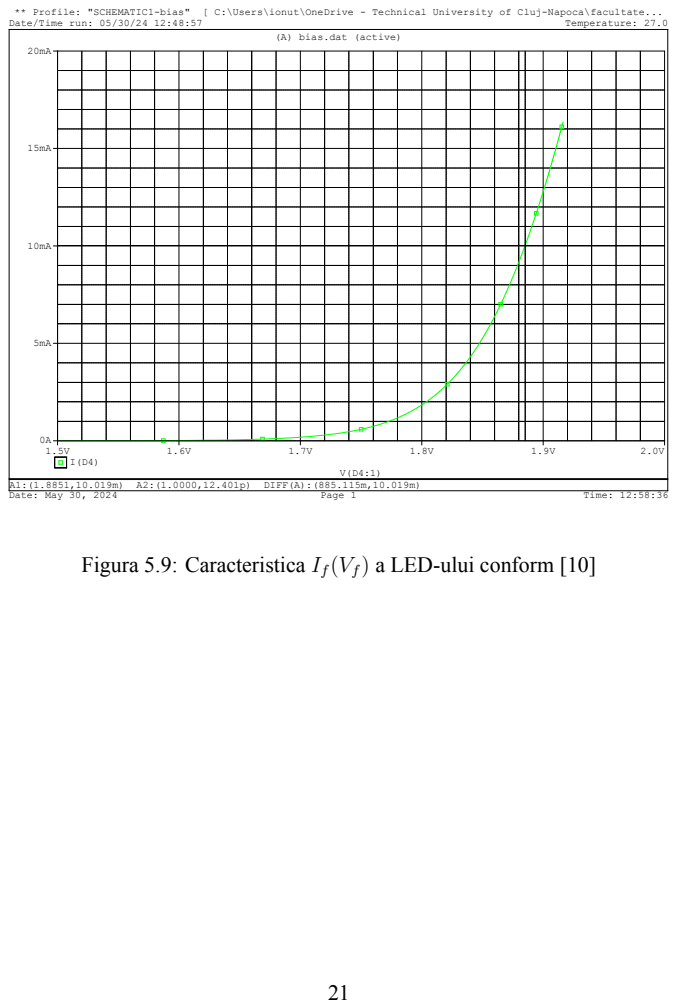
[picture p23: page 22]
A1:(1.8851,10.019m) A2:(1.0000,12.401p) DIFF(A):(885.115m,10.019m); Temperature: 27.0; Date: May 30, 2024; Page 1; Time: 12:58:36

** Profile: "SCHEMATIC1-bias" [ C:\Users\ionut\OneDrive - Technical University of Cluj-Napoca\facultate...
Date/Time run: 05/30/24 12:48:57

(A) bias.dat (active)

Figura 5.9: Caracteristica If (Vf ) a LED-ului conform [10]

### Bibliografie

[1] Warren Brayshaw, Standard EIA Decade Resistor Values Table, 2010, URL: https://www.
logwell.com/tech/components/resistor_values.html.
[2] Romul COPINDEAN, „Laborator Punți de Mǎsurǎ - Mǎsurǎri în Electronicǎ și Telecomunicații”, în (2023), pp. 5–7.
[3] Analog Devices, „AD627 datasheet”, în (2013).
[4] Analog Devices, „AD820 datasheet”, în (2011).
[5] Analog Devices, Practical Design Techniques for Sensor Signal Conditioning, PRENTICE HALL, ISBN: 0-916550-20-6.
[6] Laura IVANCIU Emilia ŞIPOȘ, Dispozitive Electronice, UTPRESS, ISBN: 978-606-737-576-3.
[7] Infineon, „IRLML2502 datasheet”, în (2014).
[8] CIT Relay și Switch, „J107F1CS1212VDC.80 datasheet”, în (2022).
[9] RohmSemi, „Impedance Characteristics of Bypass Capacitor”, în (2020).
[10] Osram Opto Semiconductors, „LED LG L29K datasheet”, în (2020).
