ocraciun/carbon_monoxide_controller/src/control_concentratie_monoxi_carbon-PSpiceFiles/SCHEMATIC1/bias/fallin_edge.pdf

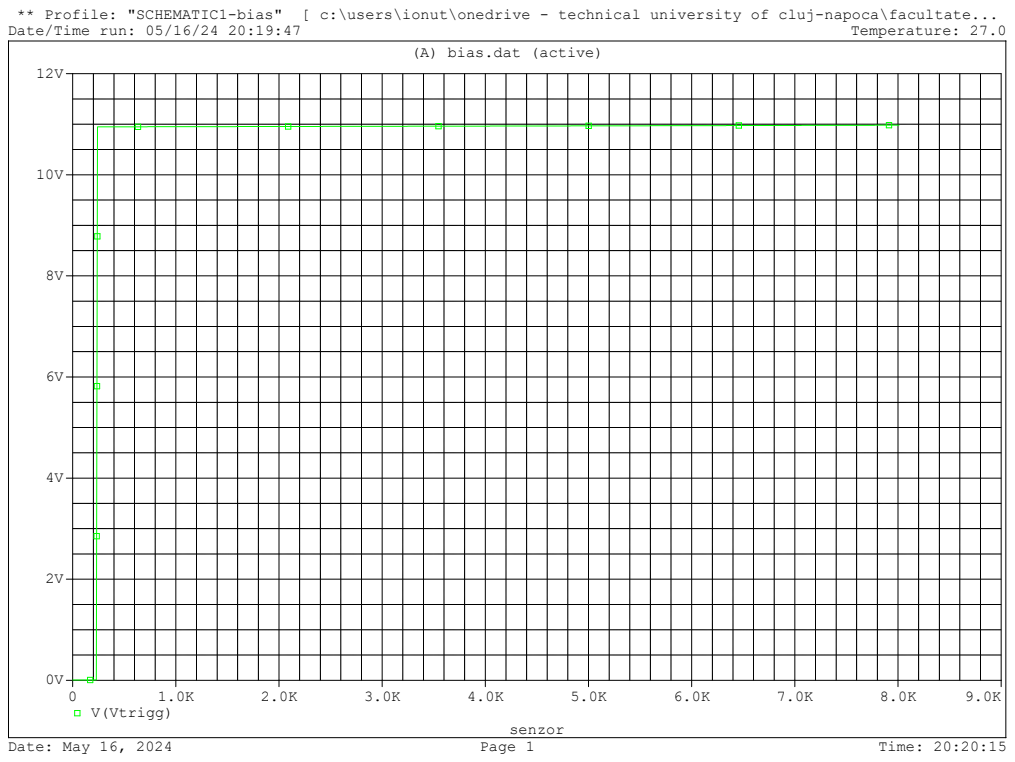
[picture p24: page 1]
Temperature: 27.0; Date: May 16, 2024; Page 1; Time: 20:20:15; senzor; V(Vtrigg)

** Profile: "SCHEMATIC1-bias" [ c:\users\ionut\onedrive - technical university of cluj-napoca\facultate...
Date/Time run: 05/16/24 20:19:47

(A) bias.dat (active)
