ocraciun/carbon_monoxide_controller/src/control_concentratie_monoxi_carbon-PSpiceFiles/SCHEMATIC1/bias/rising_edge.pdf

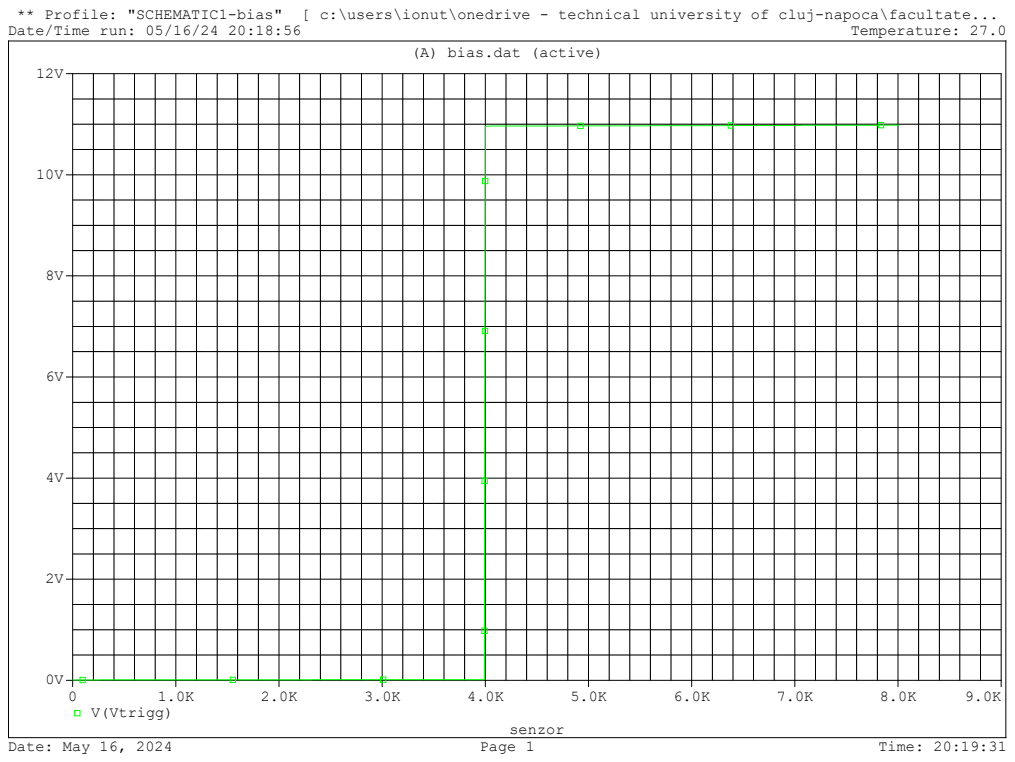
[picture p26: page 1]
Temperature: 27.0; Date: May 16, 2024; Page 1; Time: 20:19:31; senzor; V(Vtrigg)

** Profile: "SCHEMATIC1-bias" [ c:\users\ionut\onedrive - technical university of cluj-napoca\facultate...
Date/Time run: 05/16/24 20:18:56

(A) bias.dat (active)
