ocraciun/carbon_monoxide_controller/src/control_concentratie_monoxi_carbon-PSpiceFiles/SCHEMATIC1/monte_carlo_falling/monte_carlo_falling.pdf

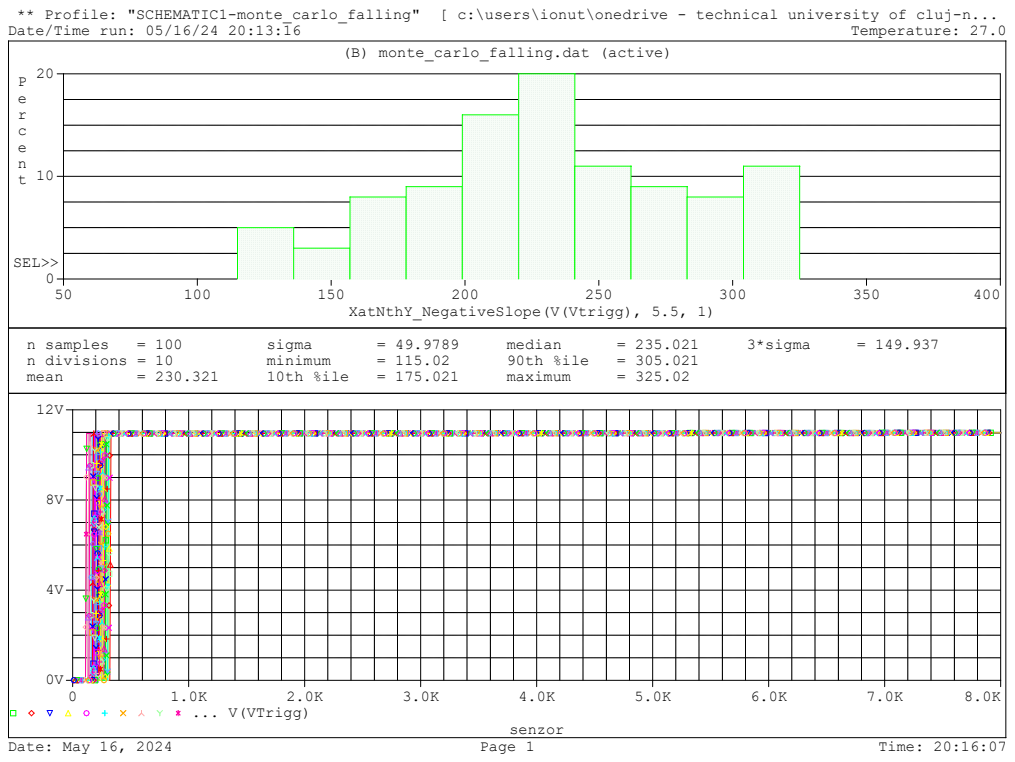
[picture p27: page 1]
Temperature: 27.0; Date: May 16, 2024; Page 1; Time: 20:16:07; (B) monte_carlo_falling.dat (active); senzor; ... V(VTrigg); XatNthY_NegativeSlope(V(Vtrigg), 5.5, 1); SEL>>; n samples; n divisions = 10; mean; sigma; minimum; 10th %ile; median; 90th %ile; maximum; 3*sigma

** Profile: "SCHEMATIC1-monte_carlo_falling" [ c:\users\ionut\onedrive - technical university of cluj-n...
Date/Time run: 05/16/24 20:13:16
