ocraciun/carbon_monoxide_controller/src/control_concentratie_monoxi_carbon-PSpiceFiles/SCHEMATIC1/monte_carlo_falling/worst_case_falling.pdf

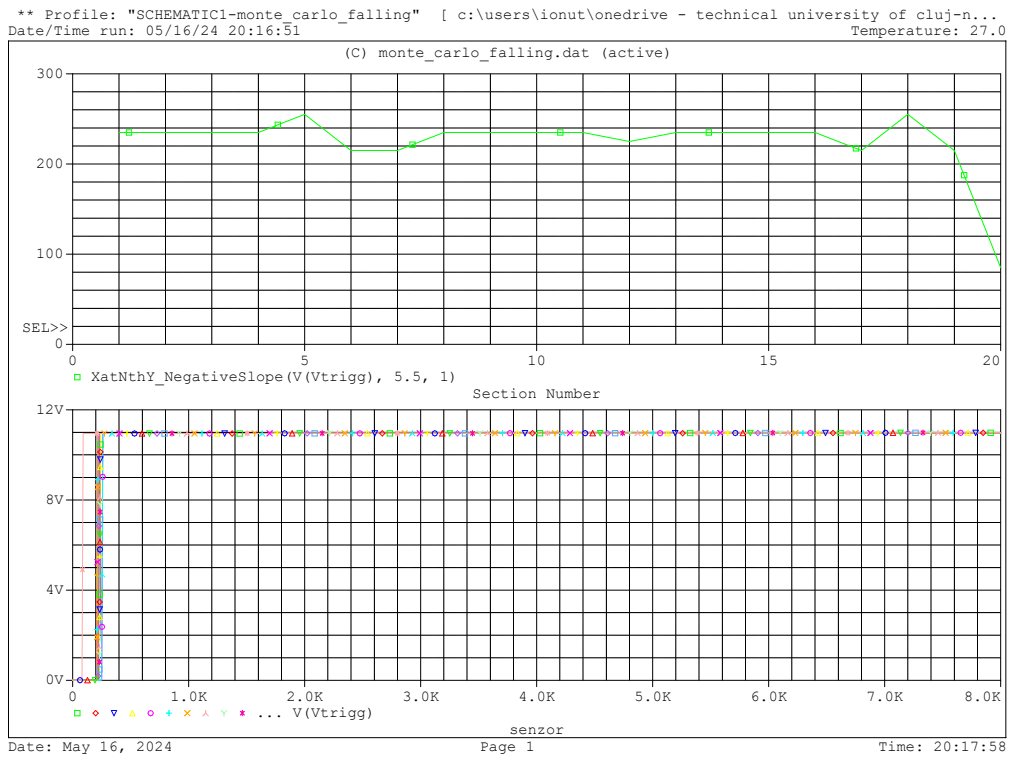
[picture p28: page 1]
Temperature: 27.0; Date: May 16, 2024; Page 1; Time: 20:17:58; (C) monte_carlo_falling.dat (active); senzor; ... V(Vtrigg); Section Number; XatNthY_NegativeSlope(V(Vtrigg), 5.5, 1); SEL>>

** Profile: "SCHEMATIC1-monte_carlo_falling" [ c:\users\ionut\onedrive - technical university of cluj-n...
Date/Time run: 05/16/24 20:16:51
