ocraciun/carbon_monoxide_controller/src/control_concentratie_monoxi_carbon-PSpiceFiles/SCHEMATIC1/monte_carlo_rising/monte_carlo_rising.pdf

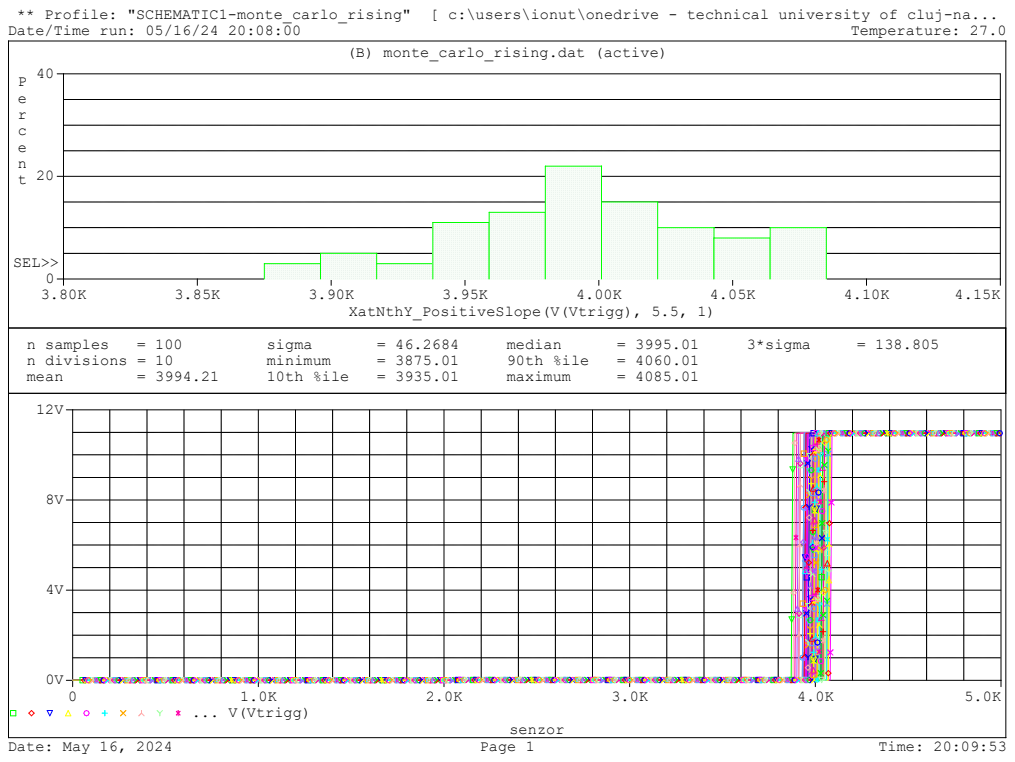
[picture p29: page 1]
Temperature: 27.0; Date: May 16, 2024; Page 1; Time: 20:09:53; (B) monte_carlo_rising.dat (active); senzor; ... V(Vtrigg); XatNthY_PositiveSlope(V(Vtrigg), 5.5, 1); SEL>>; n samples; n divisions = 10; mean; sigma; minimum; 10th %ile; median; 90th %ile; maximum; 3*sigma

** Profile: "SCHEMATIC1-monte_carlo_rising" [ c:\users\ionut\onedrive - technical university of cluj-na...
Date/Time run: 05/16/24 20:08:00
