ocraciun/carbon_monoxide_controller/src/control_concentratie_monoxi_carbon-PSpiceFiles/SCHEMATIC1/monte_carlo_rising/worst_case_falling.pdf

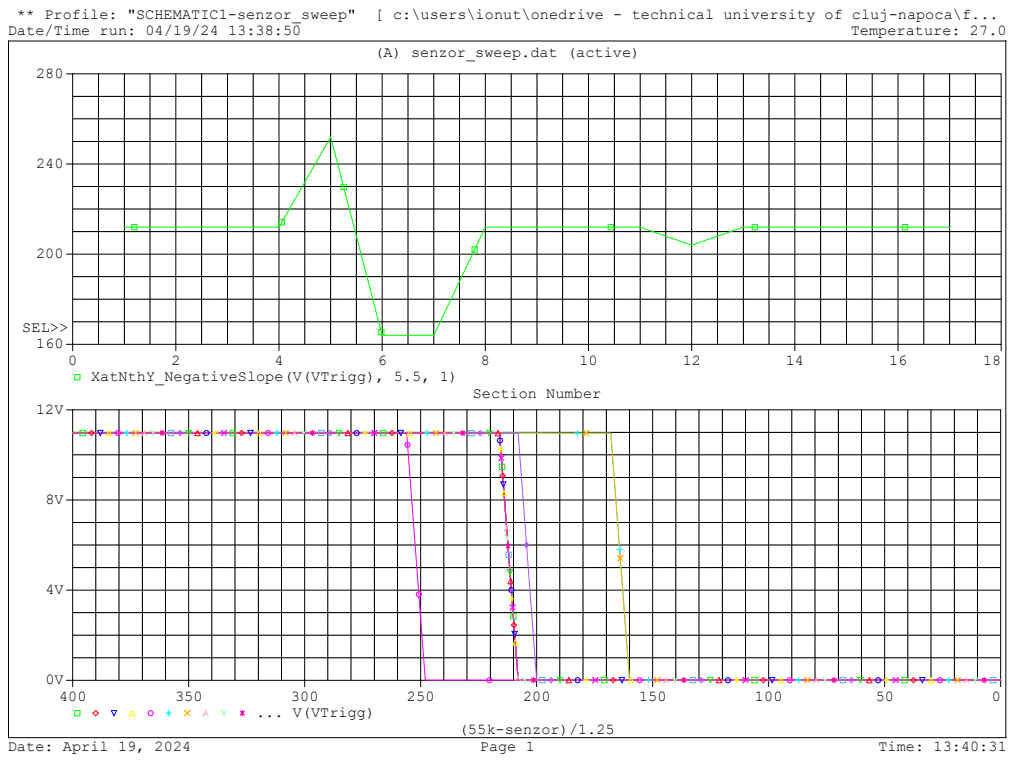
[picture p30: page 1]
Temperature: 27.0; Date: April 19, 2024; Page 1; Time: 13:40:31; (A) senzor_sweep.dat (active); (55k-senzor)/1.25; ... V(VTrigg); Section Number; XatNthY_NegativeSlope(V(VTrigg), 5.5, 1); SEL>>

** Profile: "SCHEMATIC1-senzor_sweep" [ c:\users\ionut\onedrive - technical university of cluj-napoca\f...
Date/Time run: 04/19/24 13:38:50
