ocraciun/carbon_monoxide_controller/src/control_concentratie_monoxi_carbon-PSpiceFiles/SCHEMATIC1/monte_carlo_rising/worst_case_rising.pdf

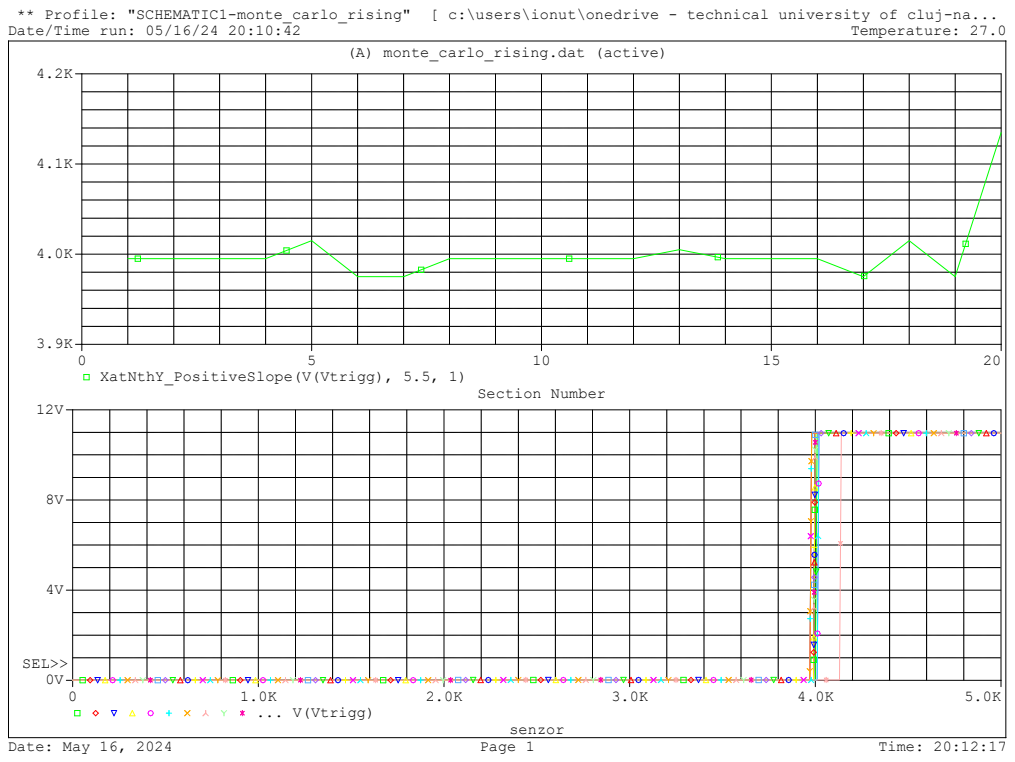
[picture p31: page 1]
Temperature: 27.0; Date: May 16, 2024; Page 1; Time: 20:12:17; (A) monte_carlo_rising.dat (active); senzor; ... V(Vtrigg); SEL>>; Section Number; XatNthY_PositiveSlope(V(Vtrigg), 5.5, 1)

** Profile: "SCHEMATIC1-monte_carlo_rising" [ c:\users\ionut\onedrive - technical university of cluj-na...
Date/Time run: 05/16/24 20:10:42
