ocraciun/carbon_monoxide_controller/src/control_concentratie_monoxi_carbon-PSpiceFiles/SCHEMATIC1/noise/CMRR.pdf

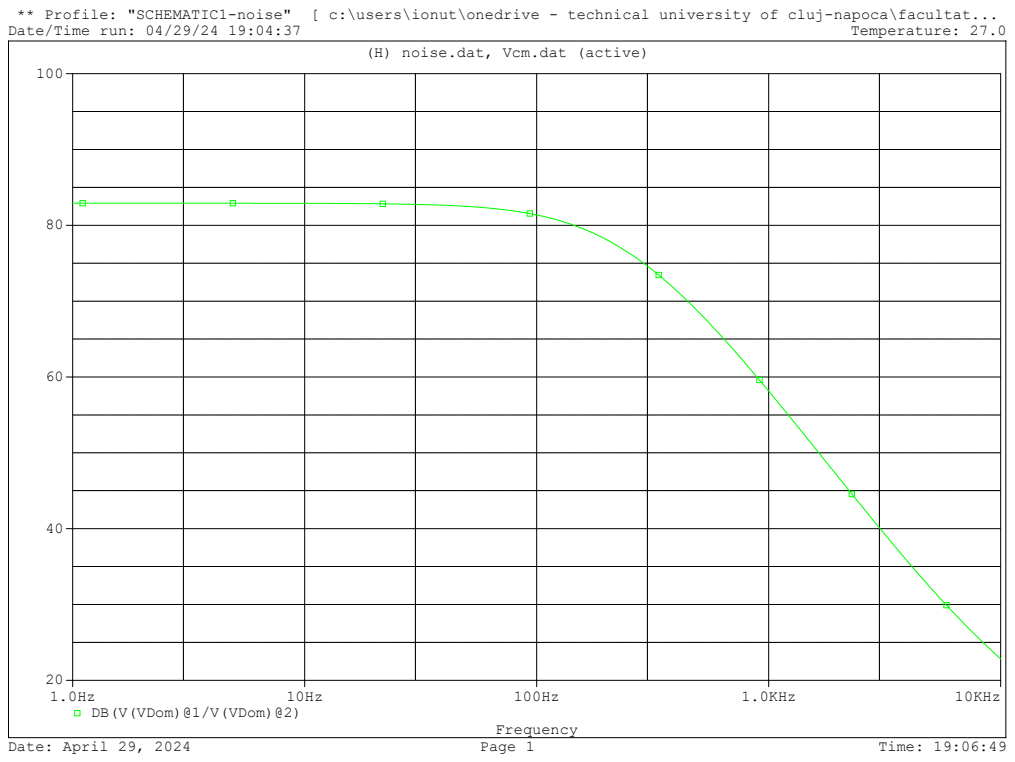
[picture p32: page 1]
Temperature: 27.0; Date: April 29, 2024; Page 1; Time: 19:06:49; Frequency; 1.0KHz; 10KHz

** Profile: "SCHEMATIC1-noise" [ c:\users\ionut\onedrive - technical university of cluj-napoca\facultat...
Date/Time run: 04/29/24 19:04:37

(H) noise.dat, Vcm.dat (active)

DB(V(VDom)@1/V(VDom)@2)
