ocraciun/carbon_monoxide_controller/src/control_concentratie_monoxi_carbon-PSpiceFiles/SCHEMATIC1/noise/noise.pdf

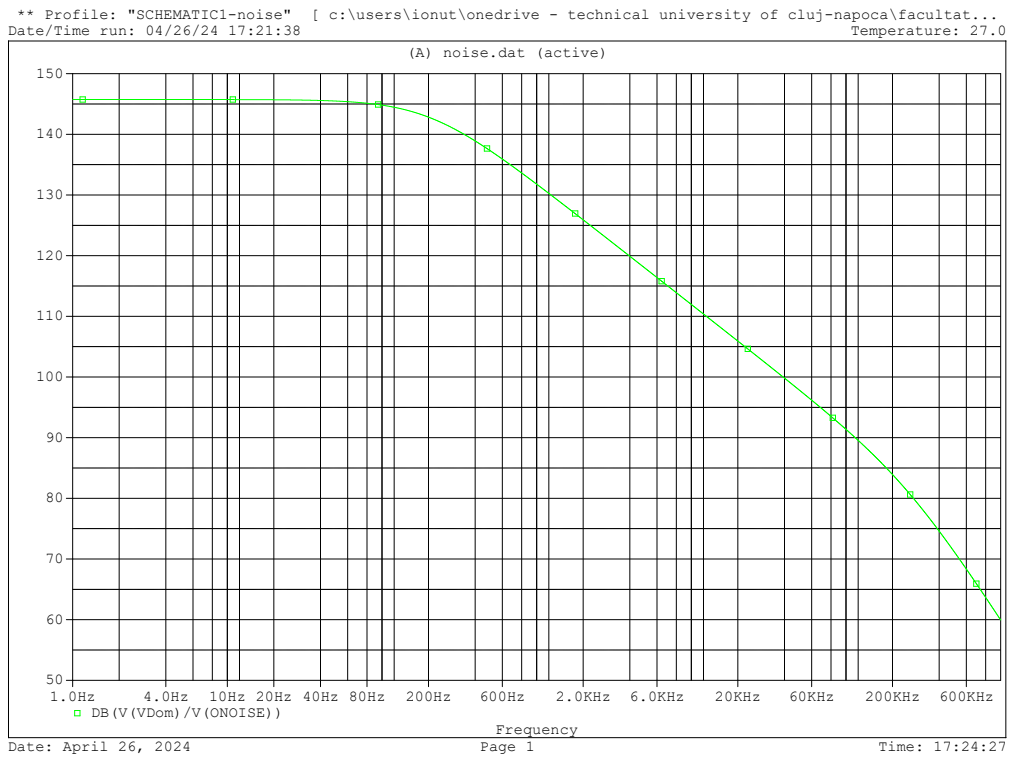
[picture p33: page 1]
Temperature: 27.0; Date: April 26, 2024; Page 1; Time: 17:24:27; Frequency; 2.0KHz 6.0KHz; 20KHz; 60KHz; 200KHz 600KHz

** Profile: "SCHEMATIC1-noise" [ c:\users\ionut\onedrive - technical university of cluj-napoca\facultat...
Date/Time run: 04/26/24 17:21:38

(A) noise.dat (active)

DB(V(VDom)/V(ONOISE))
