ocraciun/carbon_monoxide_controller/docs/schematic.pdf

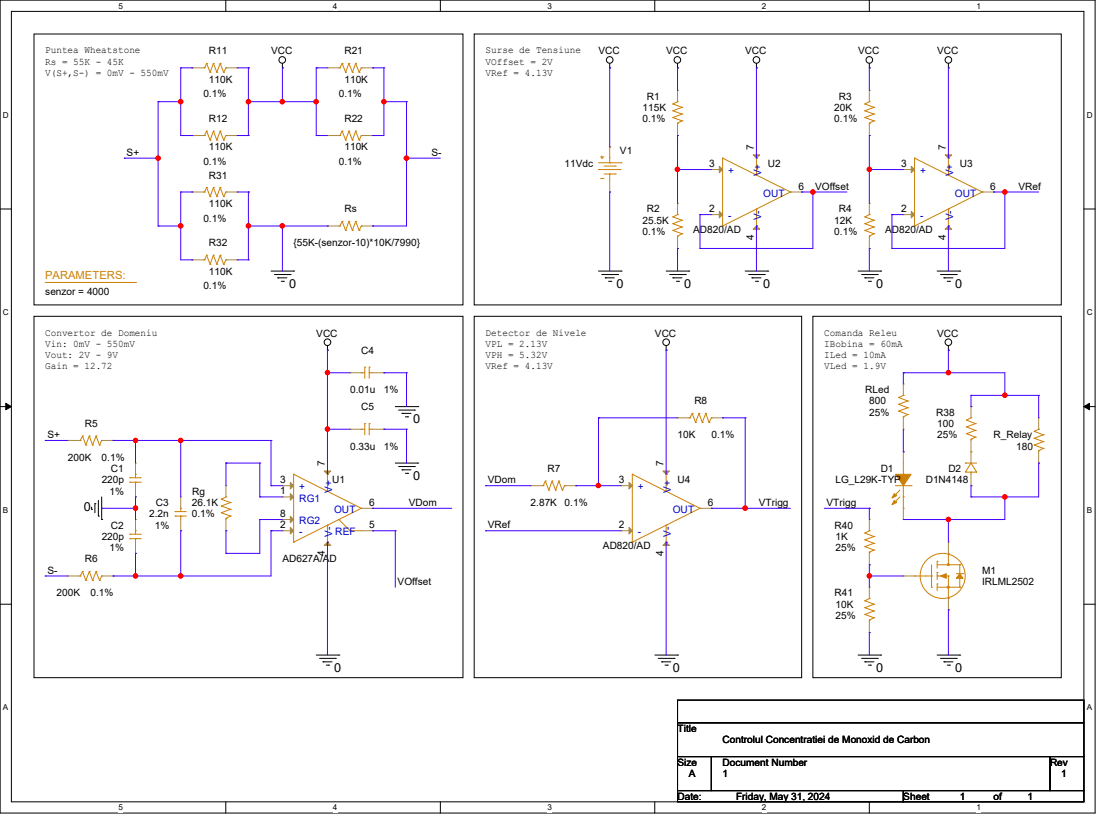
[picture p34: page 1]

Controlul Concentratiei de Monoxid de Carbon
