ocraciun/carbon_monoxide_controller/(list of files, drawings)

Other design files:
src/control_concentratie_monoxi_carbon.dsn
src/control_concentratie_monoxi_carbon.opj
